rhinocerose/eurorack-drumbox/documentation/image/Drumbox-3D_top30deg.png

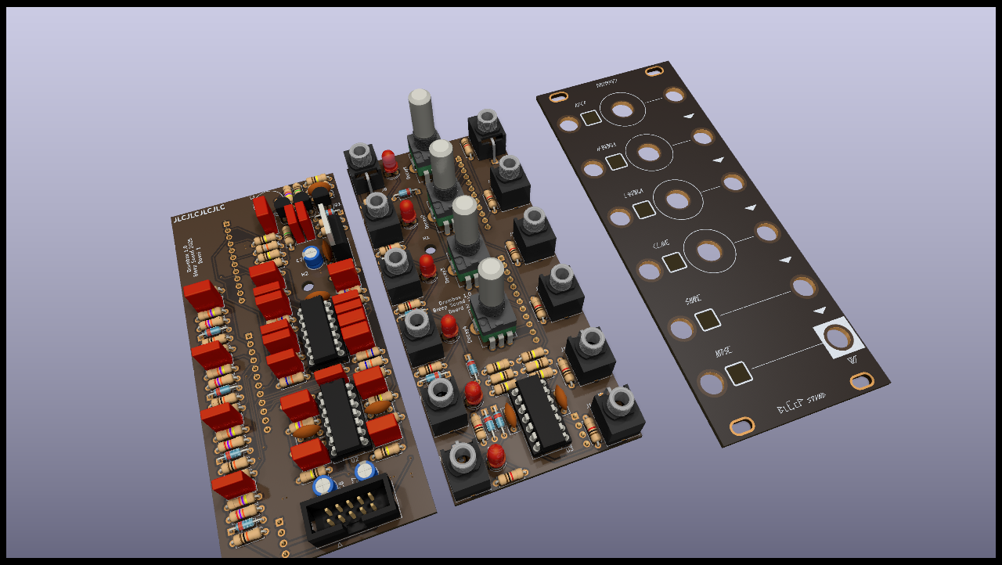
documentation/image/Drumbox-3D_top30deg.png
