rhinocerose/eurorack-drumbox/documentation/image/Drumbox-3D_top.png

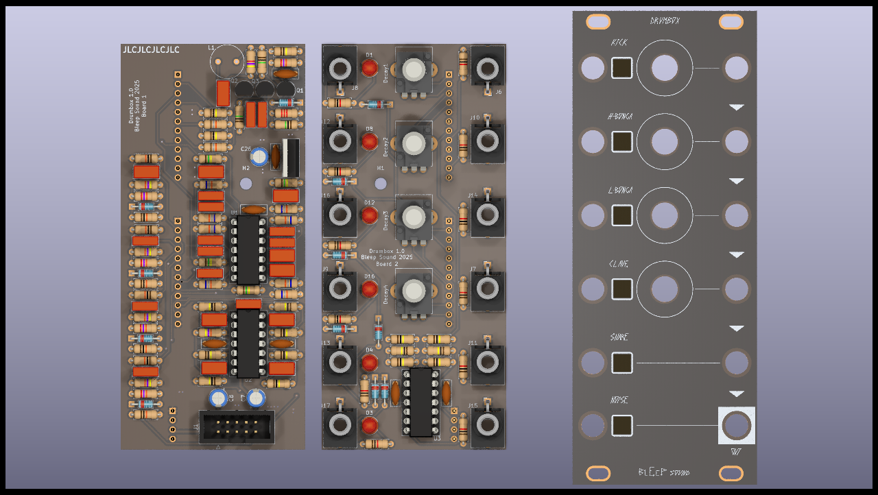
documentation/image/Drumbox-3D_top.png
