rhinocerose/eurorack-drumbox/README.md

# Drumbox

Check the website for up to date documentation

### [Bleepsound-Drumbox](https://bleepsound.github.io/drumbox/)
