rhinocerose/eurorack-drumbox/documentation/image/Drumbox-3D_bottom.png

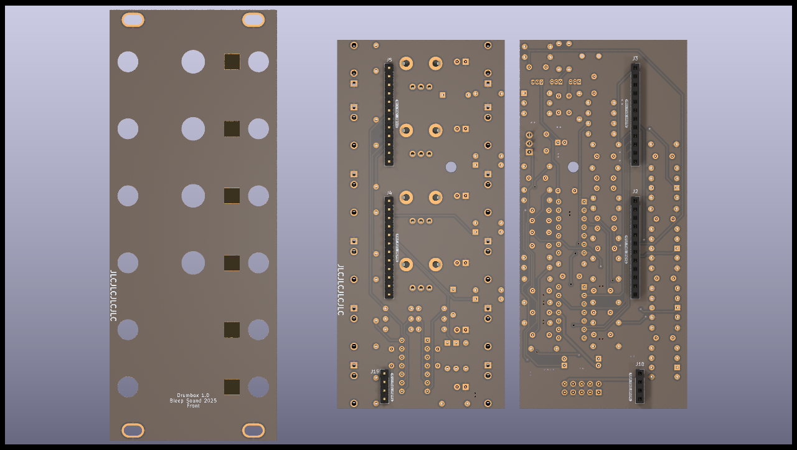
documentation/image/Drumbox-3D_bottom.png
