rhinocerose/eurorack-drumbox/documentation/image/Drumbox-top.png

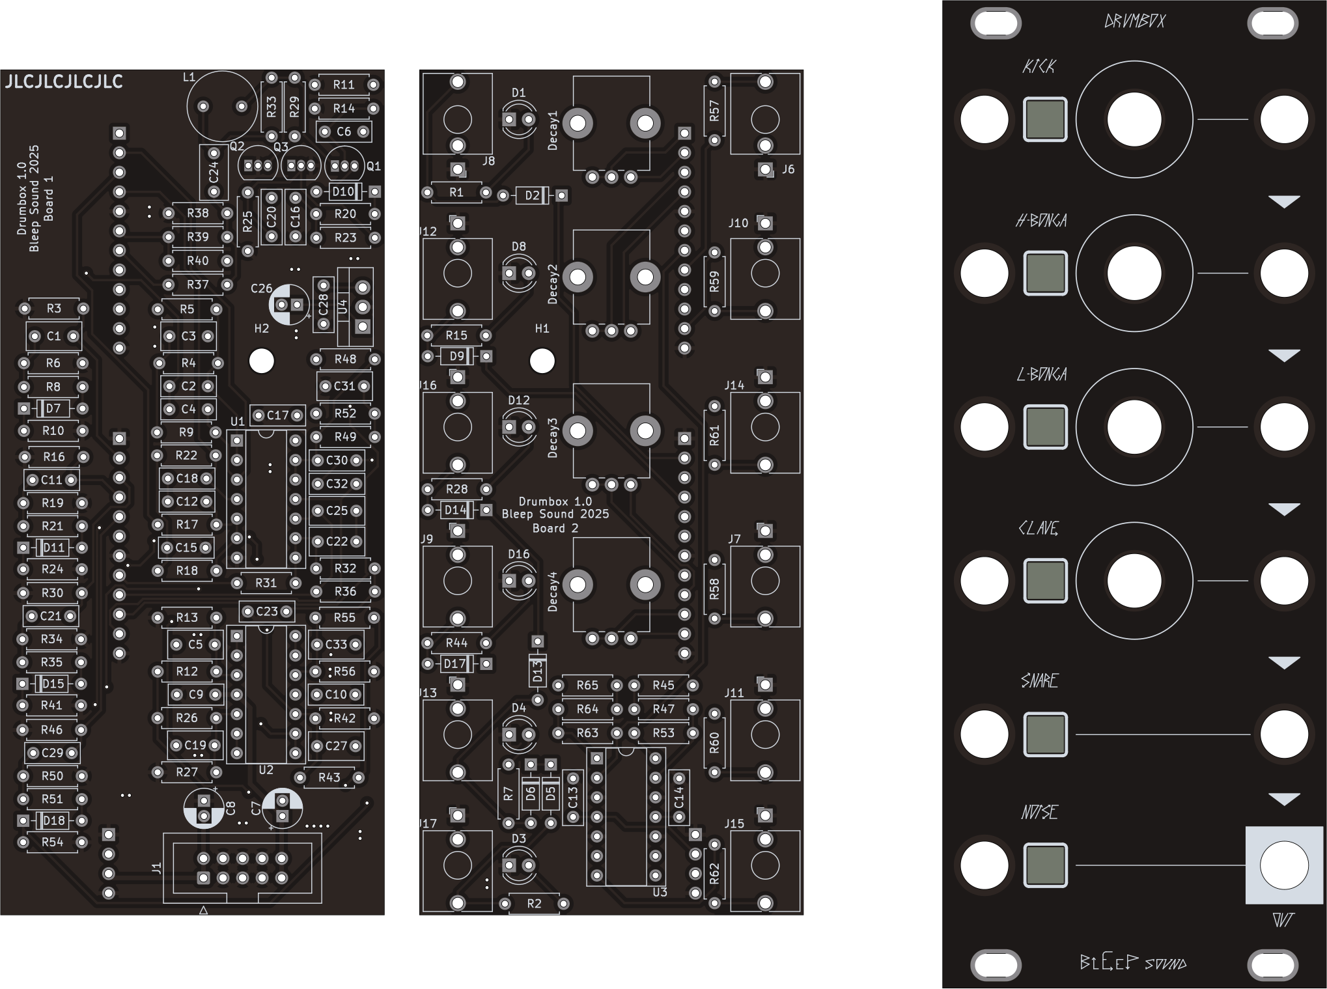
documentation/image/Drumbox-top.png
