rhinocerose/eurorack-drumbox/documentation/bom/Drumbox_V1.0--BoM.xlsx

Sheet: BoM
Drumbox_V1.0 Bill of Materials
Schematic: | Drumbox | Component Groups: | 42
Variant: | default | Component Count: | 147 (0 SMD/ 144 THT)
Revision: | 1.0 | Fitted Components: | 147 (0 SMD/ 144 THT)
Date: | 2025-02-02 | Number of PCBs: | 1
KiCad Version: | 8.0.6-8.0.6-0~ubuntu22.04.1 | Total Components: | 147
Row | Description | References | Value | Quantity Per PCB | Links
1 | 100V 5% Polyester Film Box | C30 C32 | 1.5nF | 2 | https://www.taydaelectronics.com/capacitors/polyester-film-box-type-capacitors.html
2 | 100V 5% Polyester Film Box | C20 C29 | 4.7nF | 2 | https://www.taydaelectronics.com/capacitors/polyester-film-box-type-capacitors.html
3 | 100V 5% Polyester Film Box | C31 | 4.7nF | 1 | https://www.taydaelectronics.com/capacitors/polyester-film-box-type-capacitors.html
4 | 100V 5% Polyester Film Box | C12 C18 | 10nF | 2 | https://www.taydaelectronics.com/capacitors/polyester-film-box-type-capacitors.html
5 | 100V 5% Polyester Film Box | C22 C25 | 15nF | 2 | https://www.taydaelectronics.com/capacitors/polyester-film-box-type-capacitors.html
6 | 100V 5% Polyester Film Box | C11 C15 | 33nF | 2 | https://www.taydaelectronics.com/capacitors/polyester-film-box-type-capacitors.html
7 | 100V 5% Polyester Film Box | C2 C4 C16 C21 C23 | 47nF | 5 | https://www.taydaelectronics.com/capacitors/polyester-film-box-type-capacitors.html
8 | Ceramic disc capacitor 50V 20% | C6 C9 C10 C13 C14 C17 C28 | 100nF | 7 | https://www.taydaelectronics.com/capacitors/ceramic-disc-capacitors/test-group-2.html
9 | 100V 5% Polyester Film Box | C1 C3 | 150nF | 2 | https://www.taydaelectronics.com/capacitors/polyester-film-box-type-capacitors.html
10 | 100V 5% Polyester Film Box | C5 C19 C24 C27 C33 | 470nF | 5 | https://www.taydaelectronics.com/capacitors/polyester-film-box-type-capacitors.html
11 | 10uF Electrolytic capacitor, 2.0mm pitch, 5mm diameter | C7 C8 C26 | 10uF | 3 | https://www.taydaelectronics.com/capacitors/electrolytic-capacitors.html
12 | 1N4148 Switching diode | D2 D5 D6 D7 D9 D10 D11 D13 D14 D15 D17 D18 | 1N4148 (https://assets.nexperia.com/documents/data-sheet/1N4148_1N4448.pdf) | 12 | https://www.taydaelectronics.com/1n4148-switching-signal-diode.html
13 | 4 or 5mm THT LED | D16 | Clave-LED | 1 | https://www.taydaelectronics.com/leds/round-leds/5mm-leds.html
14 | 4 or 5mm THT LED | D8 | HBongo-LED | 1 | https://www.taydaelectronics.com/leds/round-leds/5mm-leds.html
15 | 4 or 5mm THT LED | D1 | Kick-LED | 1 | https://www.taydaelectronics.com/leds/round-leds/5mm-leds.html
16 | 4 or 5mm THT LED | D12 | LBongo-LED | 1 | https://www.taydaelectronics.com/leds/round-leds/5mm-leds.html
17 | 4 or 5mm THT LED | D3 | Noise-LED | 1 | https://www.taydaelectronics.com/leds/round-leds/5mm-leds.html
18 | 4 or 5mm THT LED | D4 | Snare-LED | 1 | https://www.taydaelectronics.com/leds/round-leds/5mm-leds.html
19 | Alpha/bourns vertical potentiometer | Decay1 Decay2 Decay3 Decay4 | 470k | 4 | https://www.thonk.co.uk/shop/alpha-9mm-pots/
20 | 2.54mm pitch pin socket vertical 1x12pos | J2 J3 | Conn_Circuit | 2
21 | 2.54mm pitch pin header vertical 1x12pos | J4 J5 | Conn_Jack | 2
22 | 2.54mm pitch pin socket vertical 1x4pos | J18 | Conn_power | 1
23 | 2.54mm pitch pin header vertical 1x4pos | J19 | Conn_power | 1
24 | Thonkiconn jack | J8 J9 J12 J13 J16 J17 | Input | 6 | https://www.thonk.co.uk/shop/thonkiconn/
25 | Thonkiconn jack | J6 J7 J10 J11 J14 J15 | Output | 6 | https://www.thonk.co.uk/shop/thonkiconn/
26 | Eurorack 10 pin shrouded power header IDC | J1 | Power Input | 1 | https://www.thonk.co.uk/shop/eurorack-diy-essentials/
27 | Inductor 100mH 5mm Pitch 9x13 (DxH) | L1 | 100mH | 1 | https://www.ebay.co.uk/itm/293453947951?var=592268786436
28 | 2N3904 NPN General Purpose Transistor | Q1 Q2 Q3 | 2N3904 (https://www.onsemi.com/pub/Collateral/BC550-D.pdf) | 3 | https://www.taydaelectronics.com/2n3904-npn-general-propose-transistor.html
29 | 2.5mm*6.8mm 1/4W 1% Metal film resistor | R1 R2 R7 R15 R28 R44 R57 R58 R59 R60 R61 R62 | 1k | 12 | https://www.taydaelectronics.com/resistors/1-4w-metal-film-resistors/test-group-2.html
30 | 2.5mm*6.8mm 1/4W 1% Metal film resistor | R20 | 2k2 | 1 | https://www.taydaelectronics.com/resistors/1-4w-metal-film-resistors/test-group-2.html
31 | 2.5mm*6.8mm 1/4W 1% Metal film resistor | R33 | 4k7 | 1 | https://www.taydaelectronics.com/resistors/1-4w-metal-film-resistors/test-group-2.html
32 | 2.5mm*6.8mm 1/4W 1% Metal film resistor | R3 R10 R16 R24 R30 R41 R46 R54 | 10k | 8 | https://www.taydaelectronics.com/resistors/1-4w-metal-film-resistors/test-group-2.html
33 | 2.5mm*6.8mm 1/4W 1% Metal film resistor | R37 R39 | 18k | 2 | https://www.taydaelectronics.com/resistors/1-4w-metal-film-resistors/test-group-2.html
34 | 2.5mm*6.8mm 1/4W 1% Metal film resistor | R8 R14 R21 R35 R51 | 27k | 5 | https://www.taydaelectronics.com/resistors/1-4w-metal-film-resistors/test-group-2.html
35 | 2.5mm*6.8mm 1/4W 1% Metal film resistor | R6 R12 R19 R34 R50 | 47k | 5 | https://www.taydaelectronics.com/resistors/1-4w-metal-film-resistors/test-group-2.html
36 | 2.5mm*6.8mm 1/4W 1% Metal film resistor | R4 R9 R18 R22 R32 R36 R49 R52 | 68k | 8 | https://www.taydaelectronics.com/resistors/1-4w-metal-film-resistors/test-group-2.html
37 | 2.5mm*6.8mm 1/4W 1% Metal film resistor | R11 R13 R26 R27 R38 R40 R42 R43 R45 R47 R53 R55 R56 R63 R64 R65 | 100k | 16 | https://www.taydaelectronics.com/resistors/1-4w-metal-film-resistors/test-group-2.html
38 | 2.5mm*6.8mm 1/4W 1% Metal film resistor | R5 R17 R31 R48 | 150k | 4 | https://www.taydaelectronics.com/resistors/1-4w-metal-film-resistors/test-group-2.html
39 | 2.5mm*6.8mm 1/4W 1% Metal film resistor | R23 R25 R29 | 1M | 3 | https://www.taydaelectronics.com/resistors/1-4w-metal-film-resistors/test-group-2.html
40 | CD4011B or CD4011A, Quad NAND Gate | U1 | CD4011 (http://www.intersil.com/content/dam/Intersil/documents/cd40/cd4011bms-12bms-23bms.pdf) | 1
41 | Positive 1.5A 35V Linear Regulator, Fixed Output 5V, TO-220/TO-263/TO-252 | U4 | L7805 (http://www.st.com/content/ccc/resource/technical/document/datasheet/41/4f/b3/b0/12/d4/47/88/CD00000444.pdf/files/CD00000444.pdf/jcr:content/translations/en.CD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) | 1
42 | Quad Low-Noise JFET-Input Operational Amplifiers, DIP-14/SOIC-14 | U2 U3 | TL074 (http://www.ti.com/lit/ds/symlink/tl071.pdf) | 2 | https://www.thonk.co.uk/shop/eurorack-diy-essentials/

Sheet: Colors
Columns colors
KiCad Fields (default)
Generated Fields
User Fields
Empty Fields
