rhinocerose/eurorack-drumbox/documentation/Drumbox_V1.0--Schematic.pdf

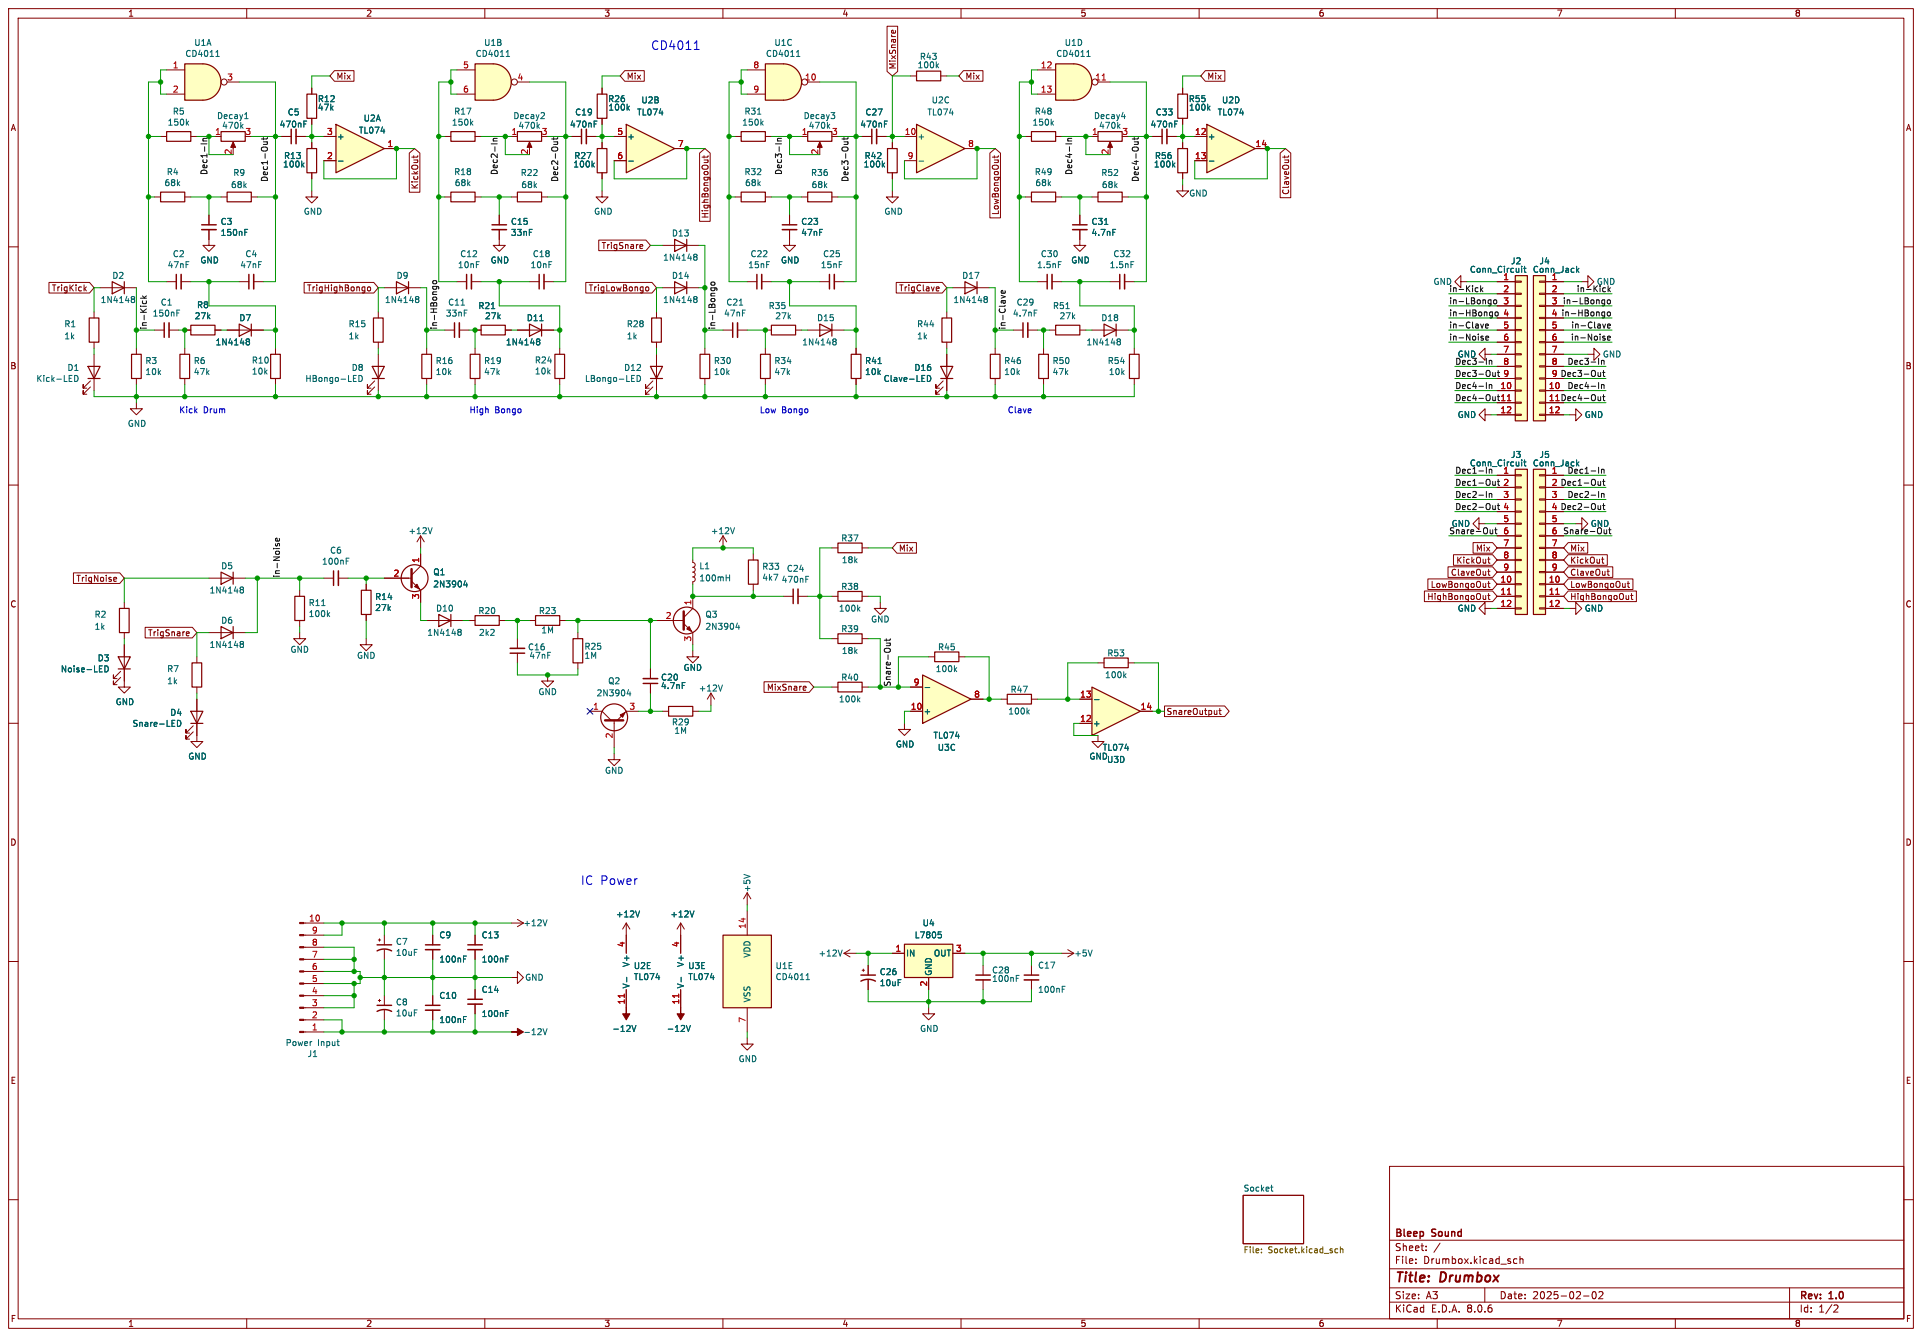
[picture p5: page 1]

Dec2-Out Dec4-In in-LBongo

in-HBongo
in-Clave Dec3-Out Dec4-Out
in-Noise Dec3-In Dec3-Out Dec4-Out Dec4-In Dec3-In

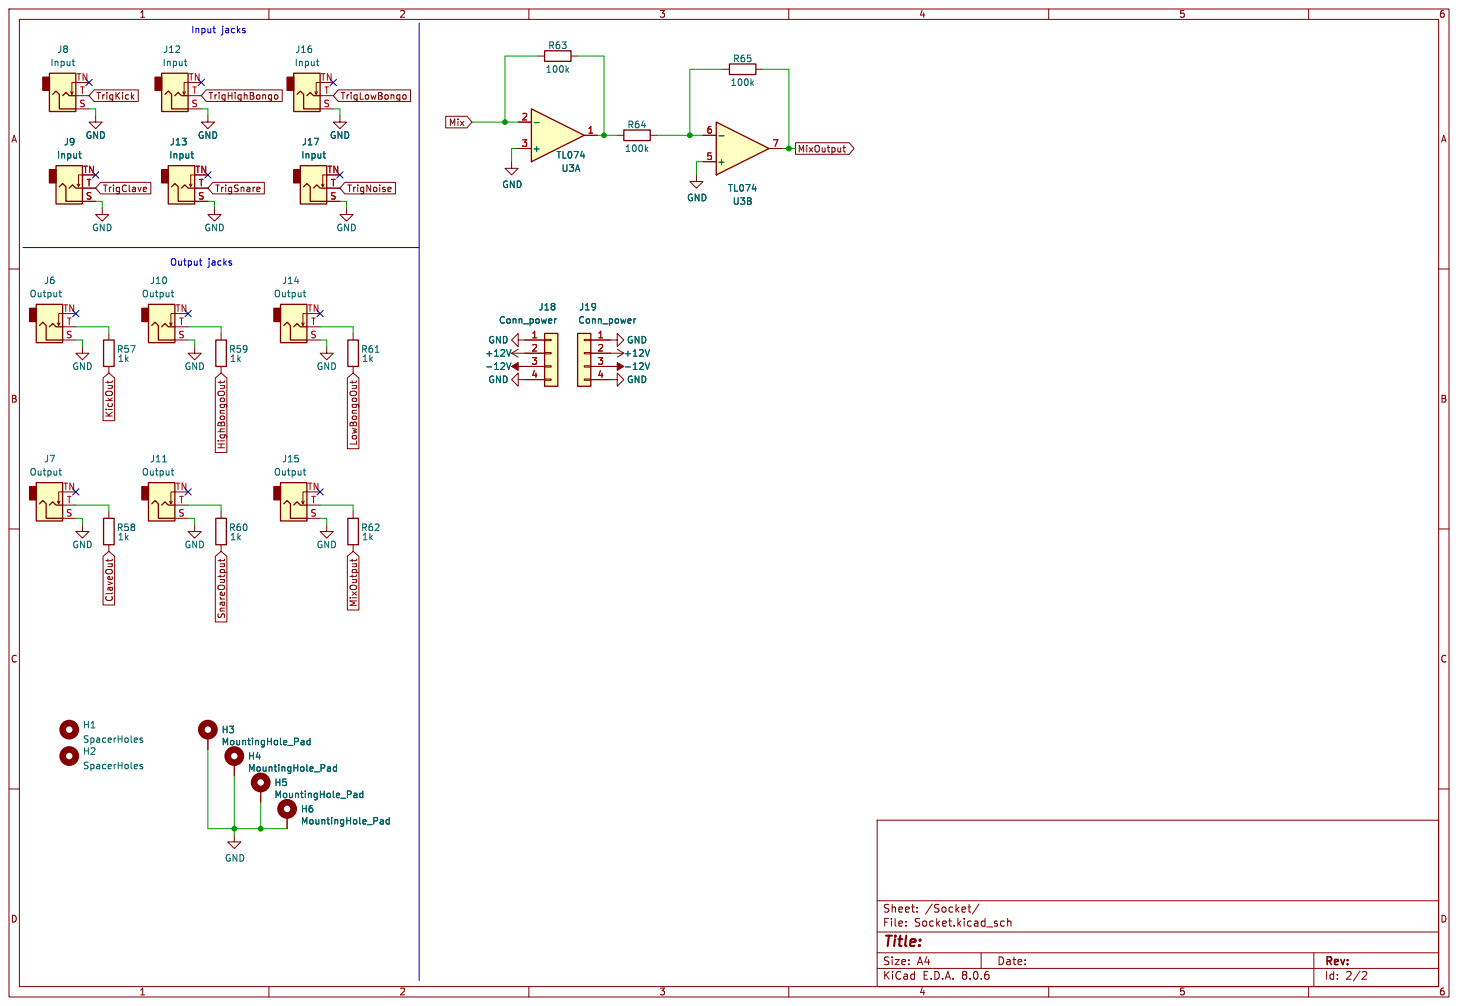
[picture p6: page 2]

Id: 2/2 Title: File: Socket.kicad_sch Sheet: /Socket/ S
