rhinocerose/eurorack-drumbox/kicad-global/Drumbox.kicad_pcb

## KiCad design kicad-global/Drumbox.kicad_pcb (2025-02-02)

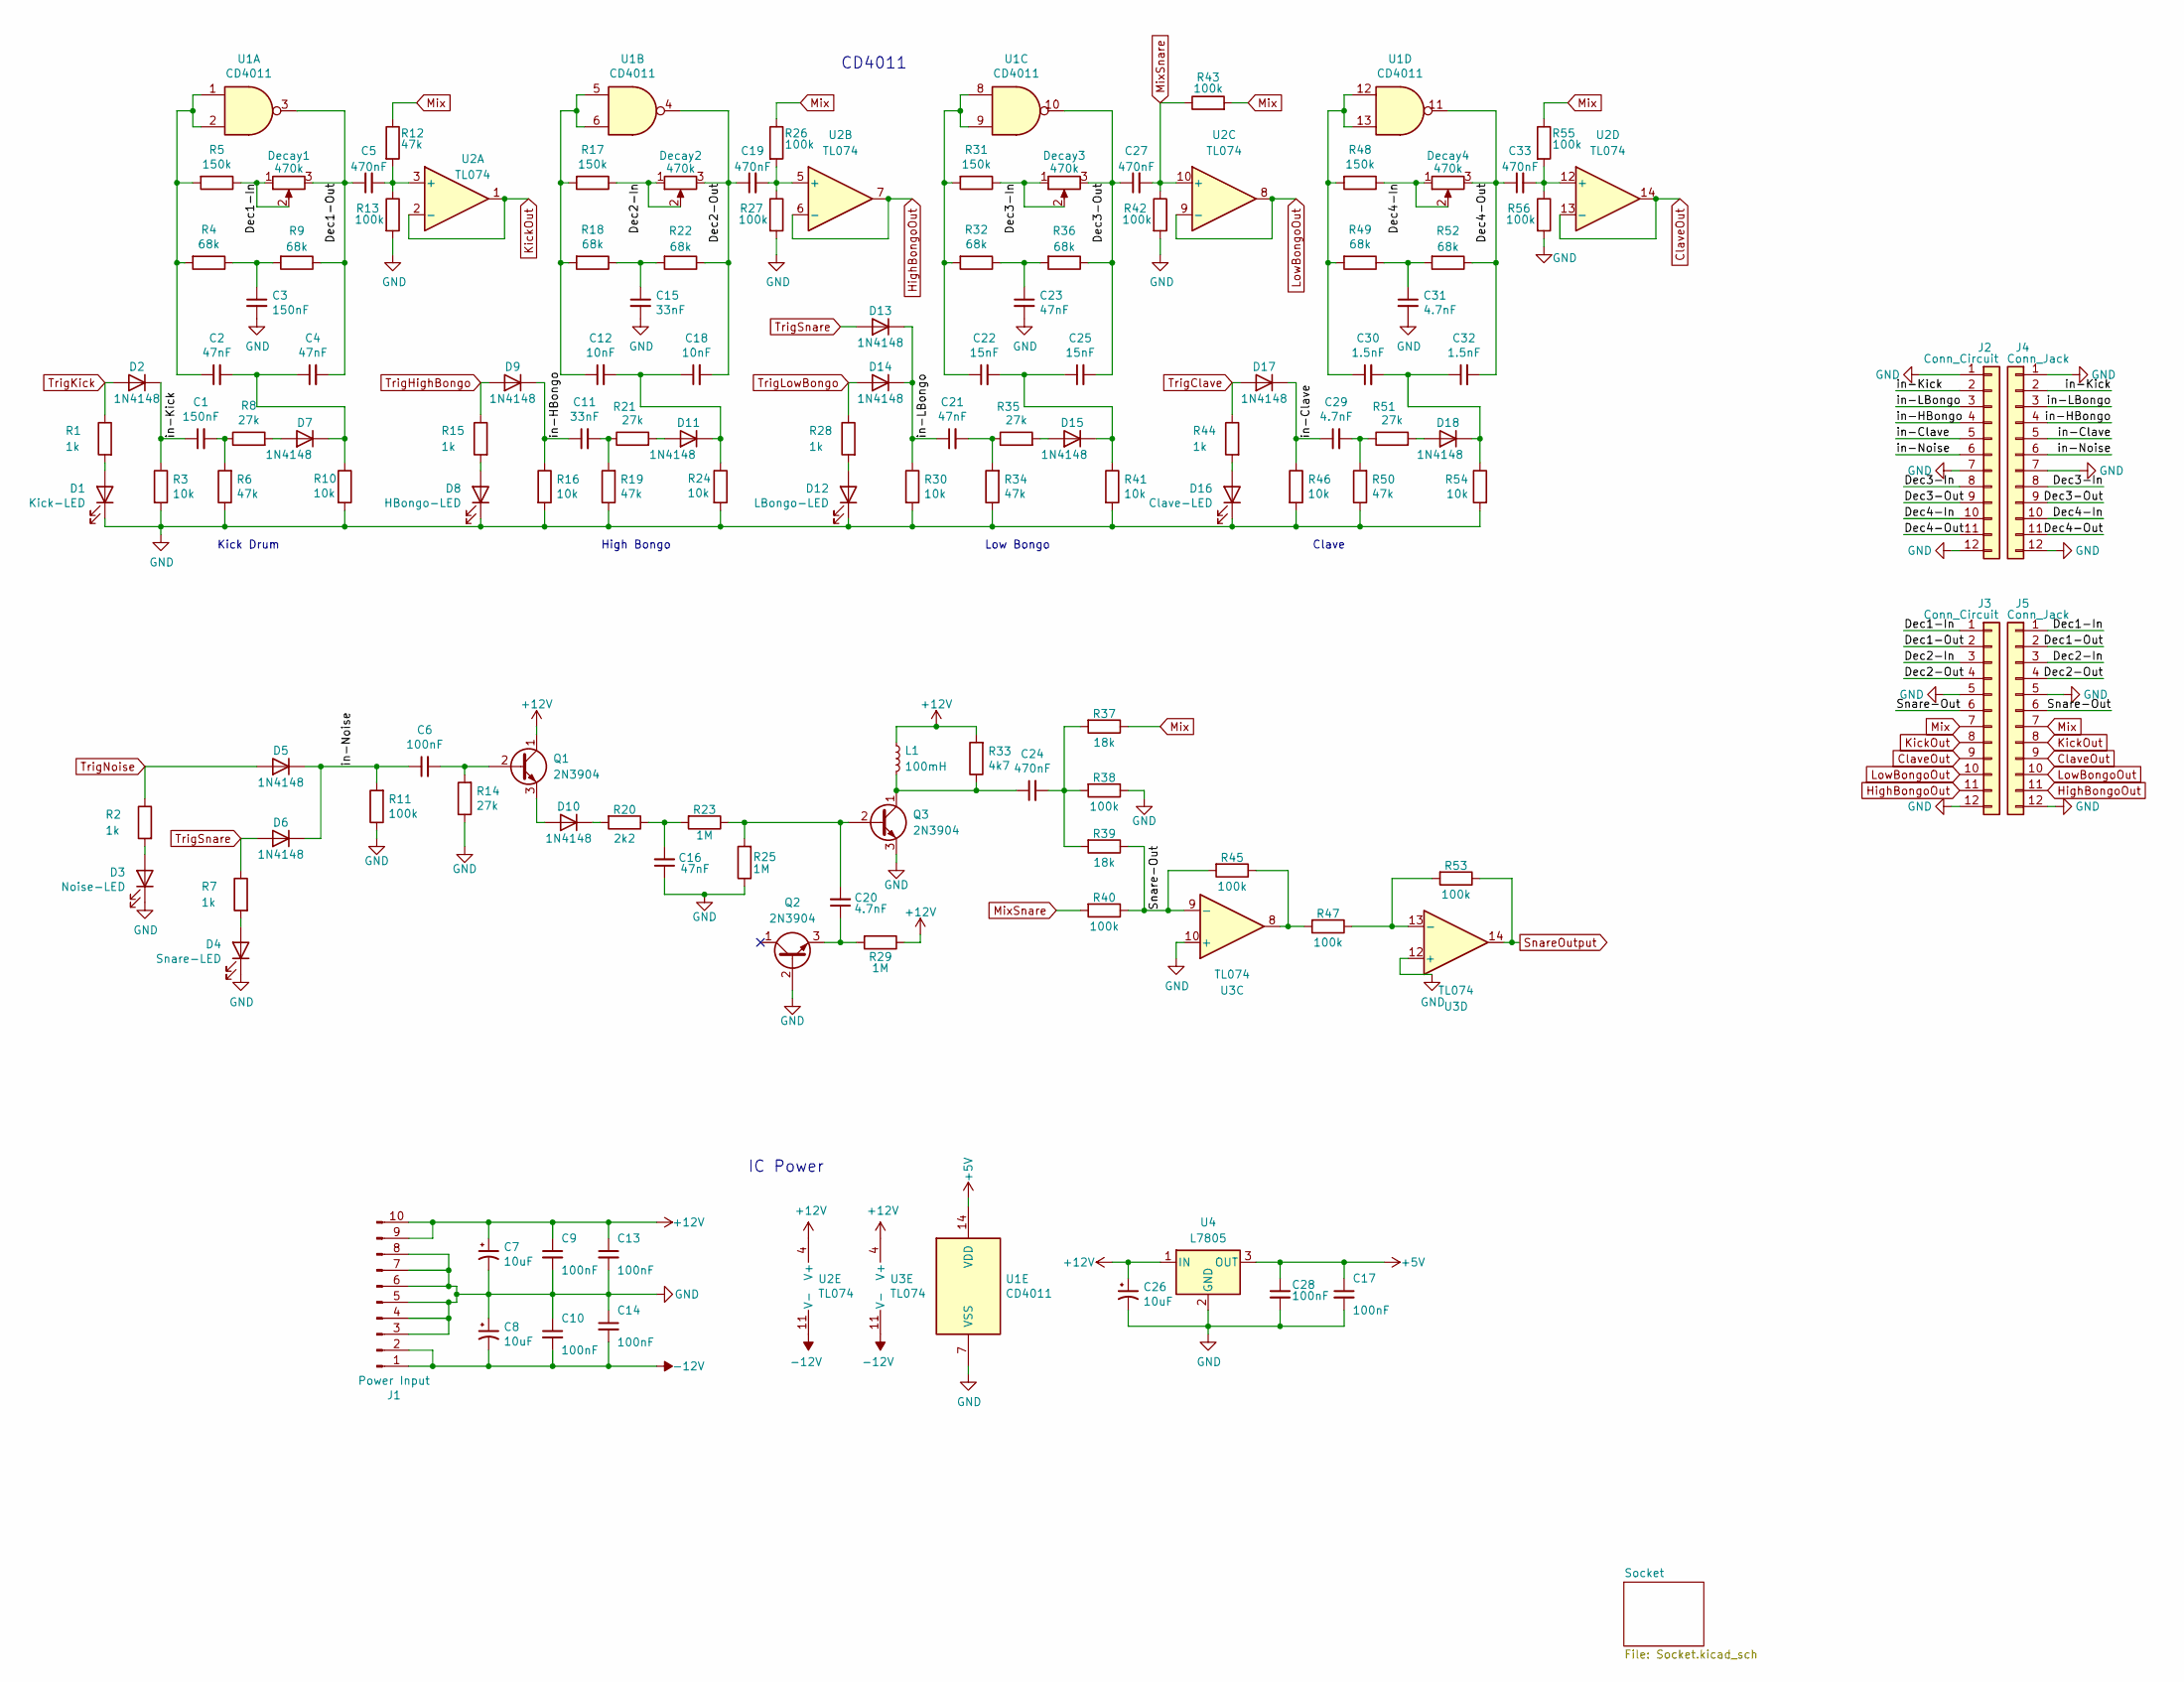
[picture p7: schematic Drumbox.kicad_sch]

Parts:
C1, C3: 150nF; C_Rect_L7.0mm_W3.5mm_P5.00mm
C2, C4, C16, C21, C23: 47nF; C_Rect_L7.0mm_W2.5mm_P5.00mm
C5, C19, C24, C27, C33: 470nF; C_Rect_L7.0mm_W3.5mm_P5.00mm
C6, C9, C10, C13, C14, C17, C28: 100nF; C_Disc_D7.0mm_W2.5mm_P5.00mm
C7, C8, C26: 10uF; CP_Radial_D5.0mm_P2.00mm
C11, C15: 33nF; C_Rect_L7.0mm_W2.5mm_P5.00mm
C12, C18: 10nF; C_Rect_L7.0mm_W2.5mm_P5.00mm
C20, C29: 4.7nF; C_Rect_L7.0mm_W2.5mm_P5.00mm
C22, C25: 15nF; C_Rect_L7.0mm_W3.5mm_P5.00mm
C30, C32: 1.5nF; C_Rect_L7.0mm_W2.5mm_P5.00mm
C31: 4.7nF; C_Rect_L7.0mm_W3.5mm_P5.00mm
D1: Kick-LED; LED_D4.0mm
D2, D5, D6, D7, D9, D10, D11, D13, D14, D15, D17, D18: 1N4148; D_DO-35_SOD27_P7.62mm_Horizontal
D3: Noise-LED; LED_D4.0mm
D4: Snare-LED; LED_D4.0mm
D8: HBongo-LED; LED_D4.0mm
D12: LBongo-LED; LED_D4.0mm
D16: Clave-LED; LED_D4.0mm
Decay1, Decay2, Decay3, Decay4: 470k; Pot-bourns-alpha
J1: Power Input; IDC-Header_2x05_P2.54mm_Vertical
J2, J3: Conn_Circuit; PinSocket_1x12_P2.54mm_Vertical
J4, J5: Conn_Jack; PinHeader_1x12_P2.54mm_Vertical
L1: 100mH; Inductor Coil
Q1, Q2, Q3: 2N3904; TO-92_Inline
R1, R2, R7, R15, R28, R44: 1k; R_Axial_DIN0207_L6.3mm_D2.5mm_P7.62mm_Horizontal
R3, R10, R16, R24, R30, R41, R46, R54: 10k; R_Axial_DIN0207_L6.3mm_D2.5mm_P7.62mm_Horizontal
R4, R9, R18, R22, R32, R36, R49, R52: 68k; R_Axial_DIN0207_L6.3mm_D2.5mm_P7.62mm_Horizontal
R5, R17, R31, R48: 150k; R_Axial_DIN0207_L6.3mm_D2.5mm_P7.62mm_Horizontal
R6, R12, R19, R34, R50: 47k; R_Axial_DIN0207_L6.3mm_D2.5mm_P7.62mm_Horizontal
R8, R14, R21, R35, R51: 27k; R_Axial_DIN0207_L6.3mm_D2.5mm_P7.62mm_Horizontal
R11, R13, R26, R27, R38, R40, R42, R43, R45, R47, R53, R55, R56: 100k; R_Axial_DIN0207_L6.3mm_D2.5mm_P7.62mm_Horizontal
R20: 2k2; R_Axial_DIN0207_L6.3mm_D2.5mm_P7.62mm_Horizontal
R23, R25, R29: 1M; R_Axial_DIN0207_L6.3mm_D2.5mm_P7.62mm_Horizontal
R33: 4k7; R_Axial_DIN0207_L6.3mm_D2.5mm_P7.62mm_Horizontal
R37, R39: 18k; R_Axial_DIN0207_L6.3mm_D2.5mm_P7.62mm_Horizontal
U1: CD4011; DIP-14_W7.62mm_Socket
U2, U3: TL074; DIP-14_W7.62mm_Socket
U4: L7805; TO-220-3_Vertical

Connections:
+5V: C17.1, C28.1, U1.14 (VDD), U4.3 (OUT)
+12V: C7.1, C9.1, C13.1, C26.1, J1.9, J1.10, L1.1, Q1.1 (C), R29.1, R33.2, U2.4 (V+), U3.4 (V+), U4.1 (IN); also elsewhere on the board
-12V: C8.2, C10.2, C14.2, J1.1, J1.2, U2.11 (V-), U3.11 (V-); also elsewhere on the board
/Dec1-In: Decay1.1, Decay1.2, J3.1, J5.1, R5.1
/Dec1-Out: C4.2, C5.1, Decay1.3, J3.2, J5.2, R9.1, U1.3
/Dec2-In: Decay2.1, Decay2.2, J3.3, J5.3, R17.1
/Dec2-Out: C18.2, C19.1, Decay2.3, J3.4, J5.4, R22.1, U1.4
/Dec3-In: Decay3.1, Decay3.2, J2.8, J4.8, R31.1
/Dec3-Out: C25.2, C27.1, Decay3.3, J2.9, J4.9, R36.1, U1.10
/Dec4-In: Decay4.1, Decay4.2, J2.10, J4.10, R48.1
/Dec4-Out: C32.2, C33.1, Decay4.3, J2.11, J4.11, R52.1, U1.11
/Snare-Out: J3.6, J5.6, R39.1, R40.1, R45.2, U3.9 (-)
/in-Clave: C29.1, D17.1 (K), J2.5, J4.5, R46.1
/in-HBongo: C11.1, D9.1 (K), J2.4, J4.4, R16.1
/in-Kick: C1.1, D2.1 (K), J2.2, J4.2, R3.1
/in-LBongo: C21.1, D13.1 (K), D14.1 (K), J2.3, J4.3, R30.1
/in-Noise: C6.1, D5.1 (K), D6.1 (K), J2.6, J4.6, R11.2
ClaveOut: J3.9, J5.9, U2.13 (-), U2.14; also elsewhere on the board
GND: C3.2, C7.2, C8.1, C9.2, C10.1, C13.2, C14.1, C15.2, C16.1, C17.2, C23.2, C26.2, C28.2, C31.2, D1.1 (K), D3.1 (K), D4.1 (K), D8.1 (K), D12.1 (K), D16.1 (K), J1.3, J1.4, J1.5, J1.6, J1.7, J1.8, J2.1, J2.7, J2.12, J3.5, J3.12, J4.1, J4.7, J4.12, J5.5, J5.12, Q2.2 (B), Q3.3 (E), R3.2, R6.1, R10.2, R11.1, R13.2, R14.1, R16.2, R19.1, R24.2, R25.1, R27.2, R30.2, R34.1, R38.1, R41.2, R42.2, R46.2, R50.1, R54.2, R56.2, U1.7 (VSS), U3.10 (+), U3.12 (+), U4.2 (GND); also elsewhere on the board
HighBongoOut: J3.11, J5.11, U2.6 (-), U2.7; also elsewhere on the board
KickOut: J3.8, J5.8, U2.1, U2.2 (-); also elsewhere on the board
LowBongoOut: J3.10, J5.10, U2.8, U2.9 (-); also elsewhere on the board
Mix: J3.7, J5.7, R12.1, R26.1, R37.1, R43.2, R55.1; also elsewhere on the board
MixSnare: C27.2, R40.2, R42.1, R43.1, U2.10 (+)
unnamed: C1.2, R6.2, R8.1
unnamed: C2.1, R4.2, R5.2, U1.1, U1.2
unnamed: C3.1, R4.1, R9.2
unnamed: C11.2, R19.2, R21.1
unnamed: C12.1, R17.2, R18.2, U1.5, U1.6
unnamed: C15.1, R18.1, R22.2
unnamed: C16.2, R20.1, R23.2
unnamed: C21.2, R34.2, R35.1
unnamed: C22.1, R31.2, R32.2, U1.8, U1.9
unnamed: C23.1, R32.1, R36.2
unnamed: C24.2, R37.2, R38.2, R39.2
unnamed: C29.2, R50.2, R51.1
unnamed: C30.1, R48.2, R49.2, U1.12, U1.13
unnamed: C31.1, R49.1, R52.2
unnamed: D1.2 (A), R1.2
unnamed: D3.2 (A), R2.2
unnamed: D4.2 (A), R7.2
unnamed: D7.2 (A), R8.2
unnamed: C2.2, C4.1, D7.1 (K), R10.1
unnamed: D8.2 (A), R15.2
unnamed: D10.2 (A), Q1.3 (E)
unnamed: D10.1 (K), R20.2
unnamed: D11.2 (A), R21.2
unnamed: C12.2, C18.1, D11.1 (K), R24.1
unnamed: D12.2 (A), R28.2
unnamed: D15.2 (A), R35.2
unnamed: C22.2, C25.1, D15.1 (K), R41.1
unnamed: D16.2 (A), R44.2
unnamed: D18.2 (A), R51.2
unnamed: C30.2, C32.1, D18.1 (K), R54.1
unnamed: C6.2, Q1.2 (B), R14.2
unnamed: C20.1, Q2.3 (E), R29.2
unnamed: C20.2, Q3.2 (B), R23.1, R25.2
unnamed: C24.1, L1.2, Q3.1 (C), R33.1
unnamed: R45.1, R47.2, U3.8
unnamed: C5.2, R12.2, R13.1, U2.3 (+)
unnamed: C19.2, R26.2, R27.1, U2.5 (+)
unnamed: C33.2, R55.2, R56.1, U2.12 (+)
unnamed: R47.1, R53.2, U3.13 (-)
SnareOutput: R53.1, U3.14; also elsewhere on the board
TrigClave: D17.2 (A), R44.1; also elsewhere on the board
TrigHighBongo: D9.2 (A), R15.1; also elsewhere on the board
TrigKick: D2.2 (A), R1.1; also elsewhere on the board
TrigLowBongo: D14.2 (A), R28.1; also elsewhere on the board
TrigNoise: D5.2 (A), R2.1; also elsewhere on the board
TrigSnare: D6.2 (A), D13.2 (A), R7.1; also elsewhere on the board

Notes on the sheet:
IC Power
High Bongo
Clave
Kick Drum
Low Bongo
CD4011

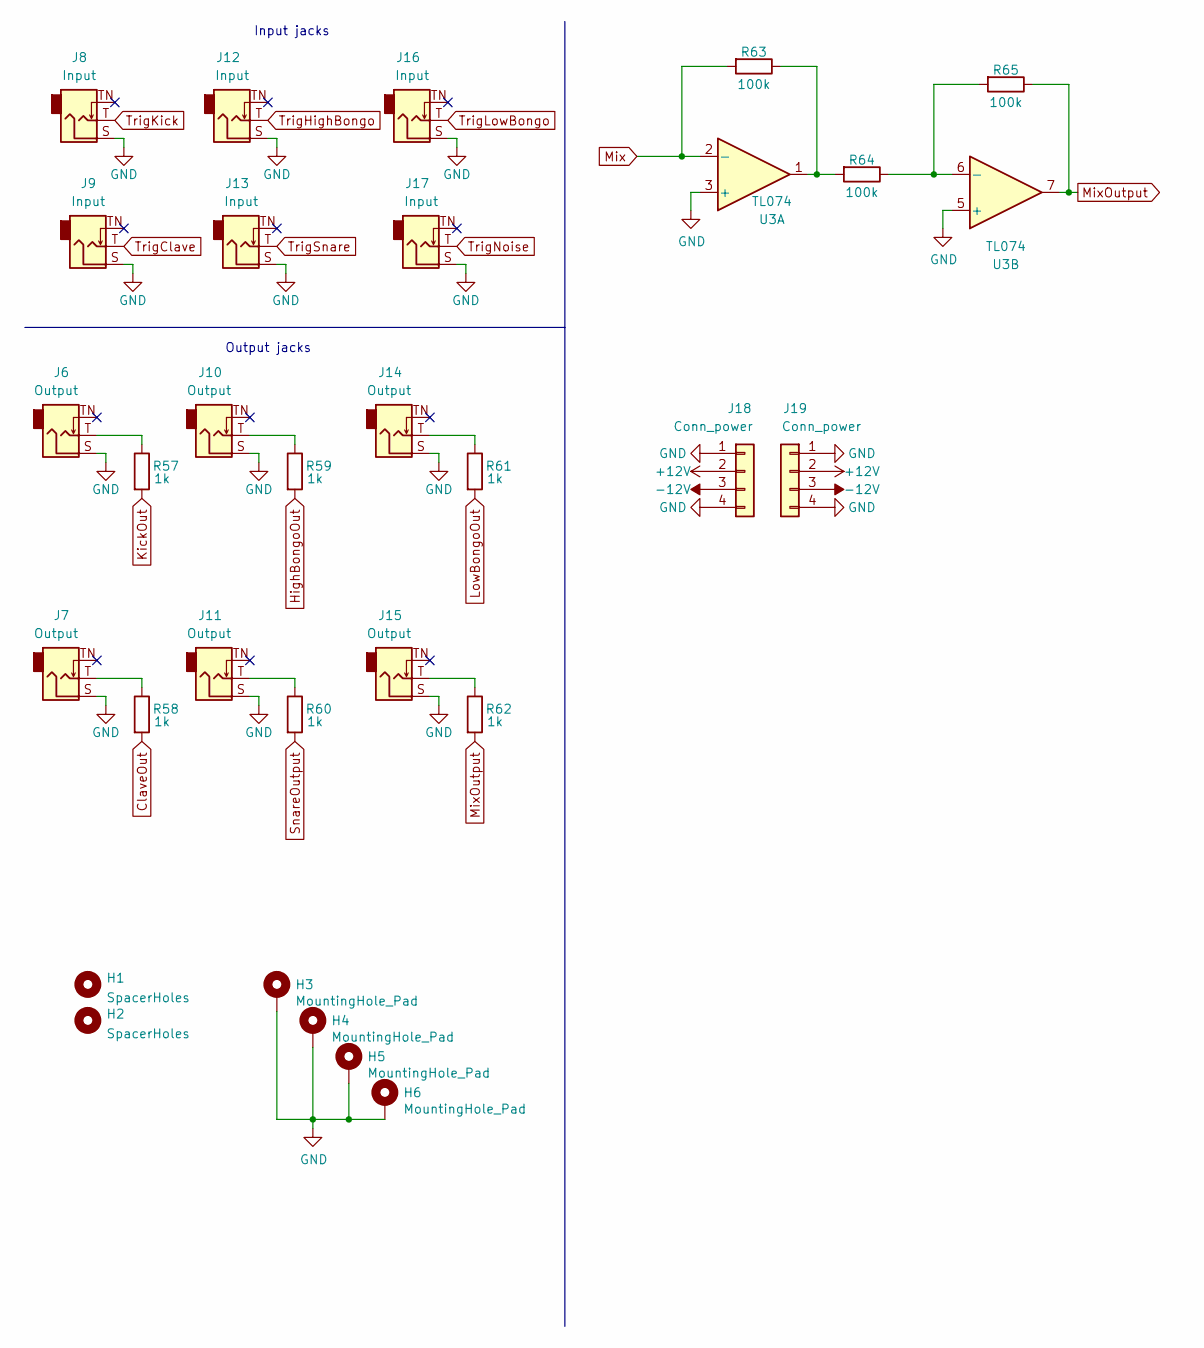
[picture p8: schematic Socket.kicad_sch]

Parts:
H1, H2: SpacerHoles; MountingHole_3.2mm_M3
H3, H4, H5, H6: MountingHole_Pad; Doepfer Mounting hole
J6, J7, J10, J11, J14, J15: Output; Thonkiconn
J8, J9, J12, J13, J16, J17: Input; Thonkiconn
J18: Conn_power; PinSocket_1x04_P2.54mm_Vertical
J19: Conn_power; PinHeader_1x04_P2.54mm_Vertical
R57, R58, R59, R60, R61, R62: 1k; R_Axial_DIN0207_L6.3mm_D2.5mm_P7.62mm_Horizontal
R63, R64, R65: 100k; R_Axial_DIN0207_L6.3mm_D2.5mm_P7.62mm_Horizontal
U3: TL074; DIP-14_W7.62mm_Socket

Connections:
+12V: J18.2, J19.2; also elsewhere on the board
-12V: J18.3, J19.3; also elsewhere on the board
ClaveOut: R58.2; also elsewhere on the board
GND: H3.1, H4.1, H5.1, H6.1, J6.S, J7.S, J8.S, J9.S, J10.S, J11.S, J12.S, J13.S, J14.S, J15.S, J16.S, J17.S, J18.1, J18.4, J19.1, J19.4, U3.3 (+), U3.5 (+); also elsewhere on the board
HighBongoOut: R59.2; also elsewhere on the board
KickOut: R57.2; also elsewhere on the board
LowBongoOut: R61.2; also elsewhere on the board
Mix: R63.2, U3.2 (-); also elsewhere on the board
MixOutput: R62.2, R65.1, U3.7
unnamed: J6.T, R57.1
unnamed: J7.T, R58.1
unnamed: J10.T, R59.1
unnamed: J11.T, R60.1
unnamed: J14.T, R61.1
unnamed: J15.T, R62.1
unnamed: R63.1, R64.2, U3.1
unnamed: R64.1, R65.2, U3.6 (-)
SnareOutput: R60.2; also elsewhere on the board
TrigClave: J9.T; also elsewhere on the board
TrigHighBongo: J12.T; also elsewhere on the board
TrigKick: J8.T; also elsewhere on the board
TrigLowBongo: J16.T; also elsewhere on the board
TrigNoise: J17.T; also elsewhere on the board
TrigSnare: J13.T; also elsewhere on the board

Notes on the sheet:
Input jacks
Output jacks

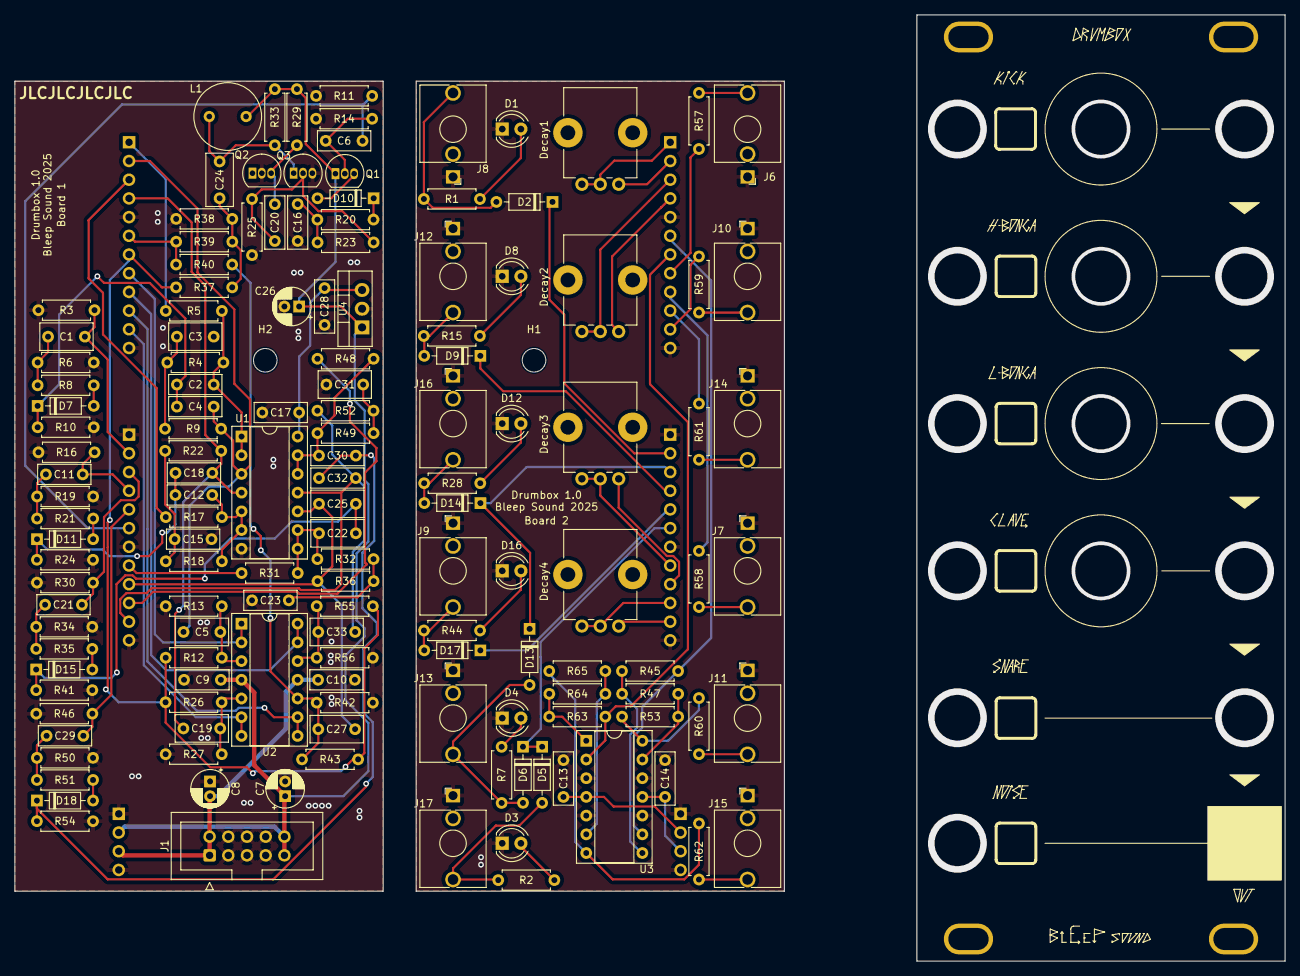
[picture p9: board Drumbox.kicad_pcb from above]

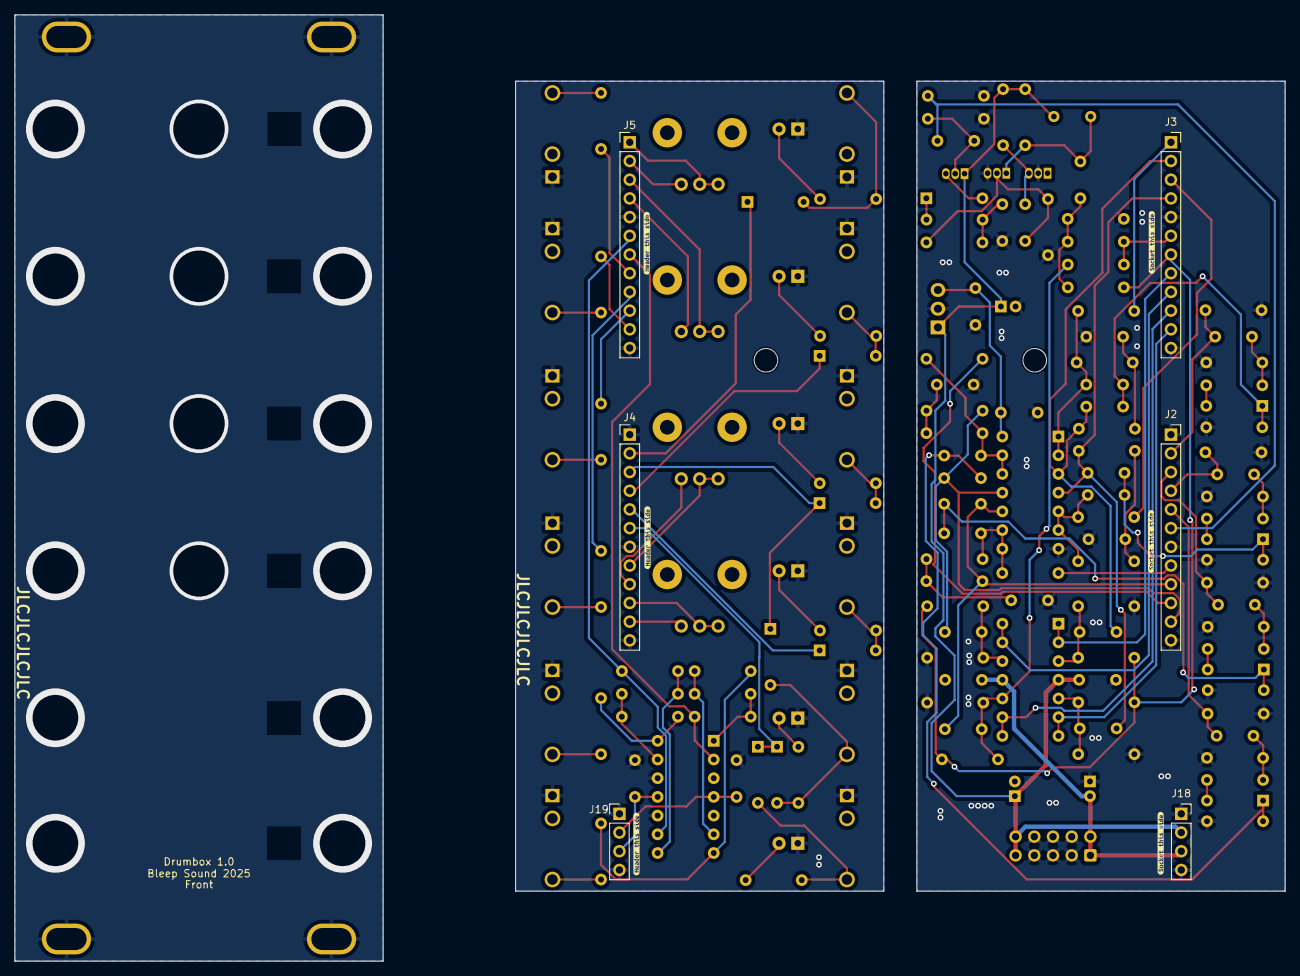
[picture p10: board Drumbox.kicad_pcb from below]

Board: 2 copper layers, 172.5 x 128.5 mm, 159 parts (12 on the bottom side), 79 nets.

Other parts of the board:
kibuzzard-67840646, kibuzzard-67840646#2, kibuzzard-67840646#3: G***; kibuzzard-67840646
kibuzzard-67840666, kibuzzard-67840666#2, kibuzzard-67840666#3: G***; kibuzzard-67840666
