rhinocerose/eurorack-drumbox/(commit log)

2025-02-02 fix issue with front
    [Drumbox--NPTH_map.gbr, Drumbox--PTH_map.gbr, Drumbox-B_Cu.gbl, Drumbox-B_Mask.gbs, Drumbox-B_Paste.gbp, Drumbox-B_Silkscreen.gbo, Drumbox-Edge_Cuts.gm1, Drumbox-F_Cu.gtl]
2025-08-12 Update submodules to track main branch
